mr-sneezy/ArduinoHondaOBD1_to_OBD2_BT/schematics/compact_schematic.pdf

SpiceOrder 2 | SpiceOrder 1 ARDUINO_NANO2

+5V

GND

GND

GND

1N4004

+12V

100R

GND

1N4734A

GND

4k7

GND

MODUL1

D1/TX

J1.1

D0/RX

J1.2

RESET

J1.3

COM

J1.4 D2

J1.5

D3

J1.6

D4

J1.7

D5

J1.8

D6

J1.9

D7

J1.10

D8

J1.11

D9

J1.12

D10

J1.13
D11/MOSI | J1.14
D12/MISO | J1.15

VIN

# J2.1 COM

J2.2

RESET

J2.3 | +5V J2.4

A7

J2.5

A6

J2.6

A5

J2.7

A4

J2.8

A3

J2.9

A2

J2.10

A1

J2.11

A0

J2.12

AREF

J2.13

3V3

# J2.14 D13/SCK

J2.15

BT_MODULE
1
2
3
4
5
6
7

HONDA_DLC
1
2
D1 | 3

R2

# + - BZ1 D2

R1

Document Number: Honda DLC to OBDII via Bluetooth Minimum parts version. | REV: 1.0
Date: 18-Aug-18 10:55 PM | Sheet: 1/1

## TITLE:

## Honda_DLC_OBDII_BT_Minimal

12V Power from DLC connector

5V micro-buzzer

Arduino Nano

5.6V
zener

Ignore pin numbering. Use the pin lables on your BT module. TXD to Nano D10. RXD to Nano D11. GND to Nano GND. 5V to Nano 5V. KEY not used. STATUS not used.

Arduino Nano: https://www.banggood.com/ATmega328P-Nano-V3-Controller-Board-Compatible-Arduino-p-940937.html

Bluetooth module: https://www.banggood.com/HC-05-Wireless-Bluetooth-Serial-Transceiver-Module-Slave-And-Master-p-908621.html

Honda DLC cable: https://www.ebay.com.au/itm/3Pin-to-16-Pin-OBD2-Female-Extension-Connector-Car-Cable-Diagnose-Tool-For-Honda/292440335602

Buzzer: https://www.banggood.com/5-Pcs-5V-Electromagnetic-Active-Buzzer-Continuous-Beep-Continuously-p-1035626.html

Notes: BT module gets power from Nano's 5V regulator.

If using Ebay Honda cable, cut off D-connector end and use the the DLC 3pin socket.
