mr-sneezy/ArduinoHondaOBD1_to_OBD2_BT/images/3.JPG

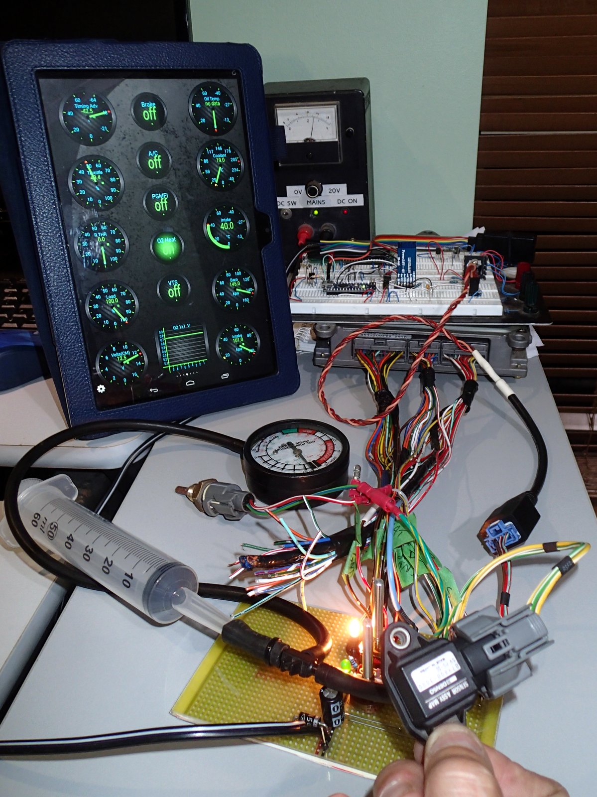
images/3.JPG
