mr-sneezy/ArduinoHondaOBD1_to_OBD2_BT/images/compact1.JPG

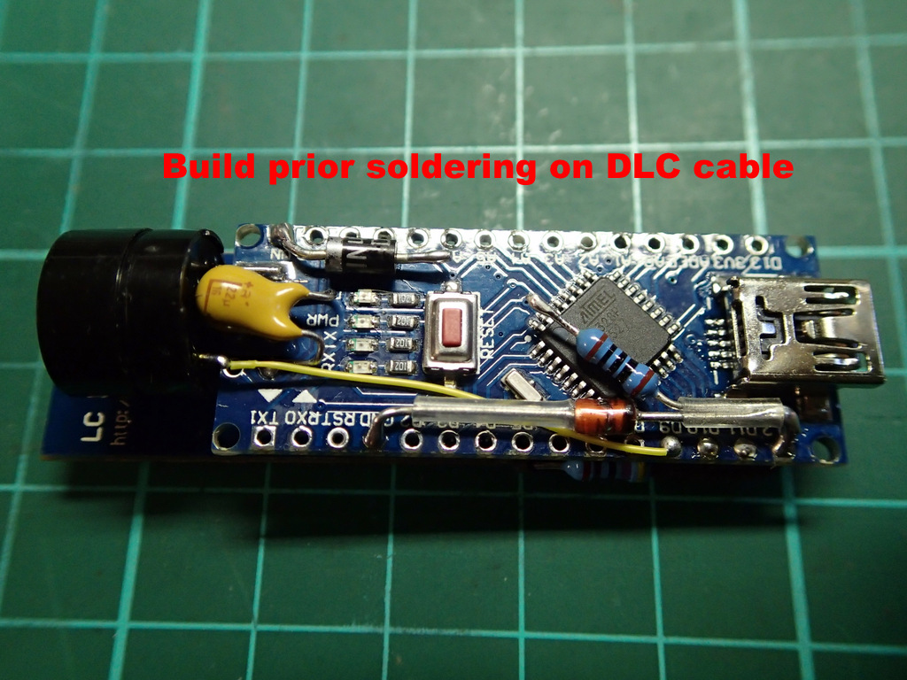
images/compact1.JPG
