mr-sneezy/ArduinoHondaOBD1_to_OBD2_BT/images/compact2.JPG

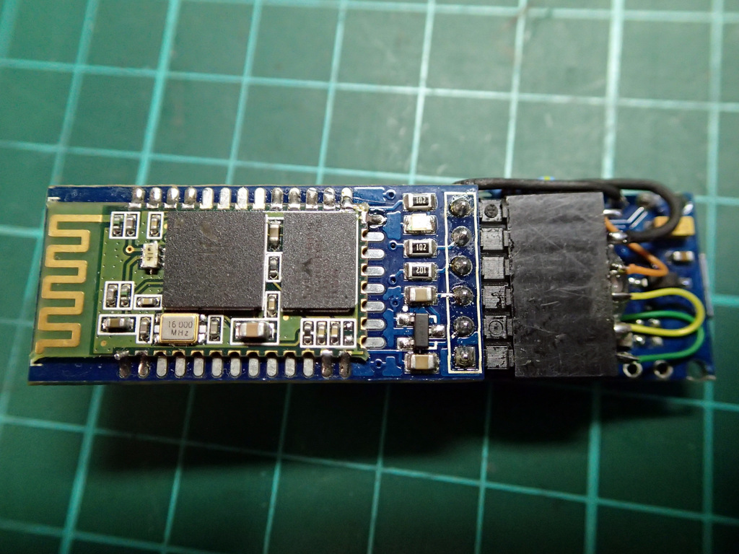
images/compact2.JPG
