mr-sneezy/ArduinoHondaOBD1_to_OBD2_BT/images/compact3.JPG

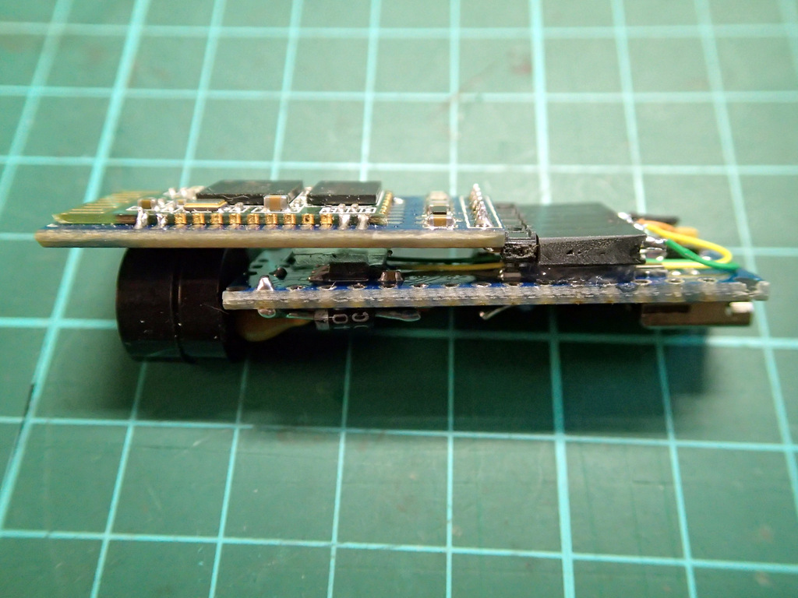
images/compact3.JPG
