mr-sneezy/ArduinoHondaOBD1_to_OBD2_BT/images/Compact version.JPG

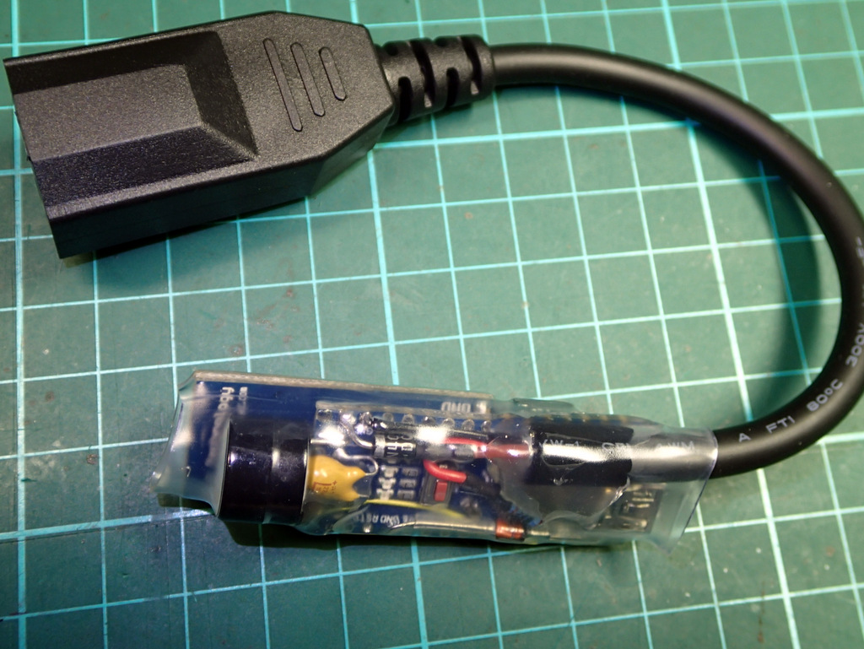
images/Compact version.JPG
