mr-sneezy/ArduinoHondaOBD1_to_OBD2_BT/images/differential_sensor.JPG

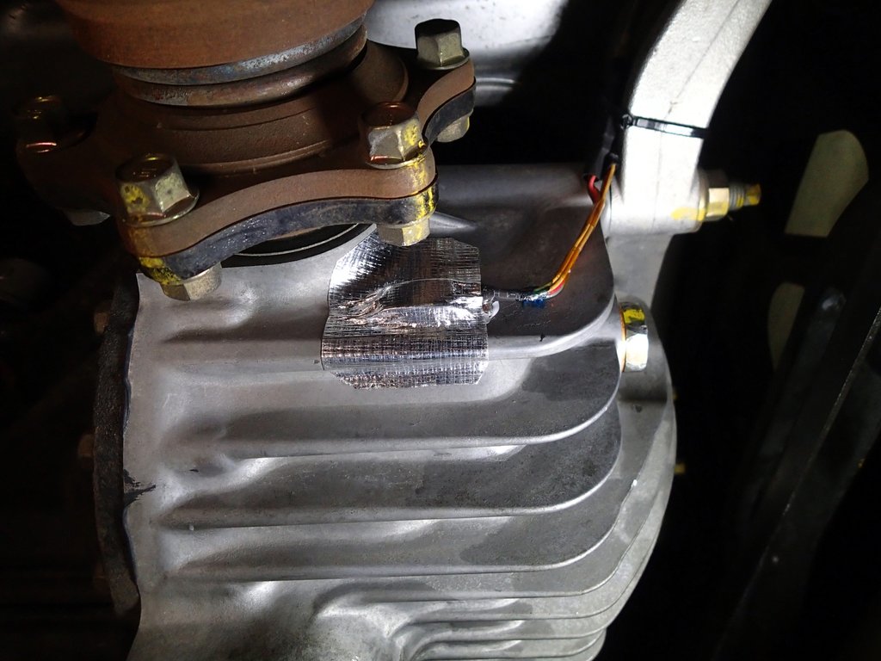
images/differential_sensor.JPG
