mr-sneezy/ArduinoHondaOBD1_to_OBD2_BT/images/expanded_sensor_version_boxed.JPG

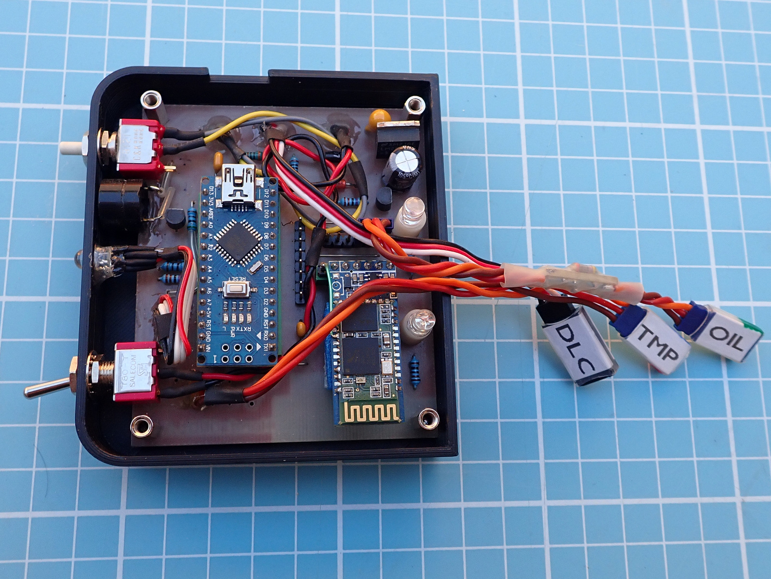
images/expanded_sensor_version_boxed.JPG
