mr-sneezy/ArduinoHondaOBD1_to_OBD2_BT/images/gearbox_sensor.JPG

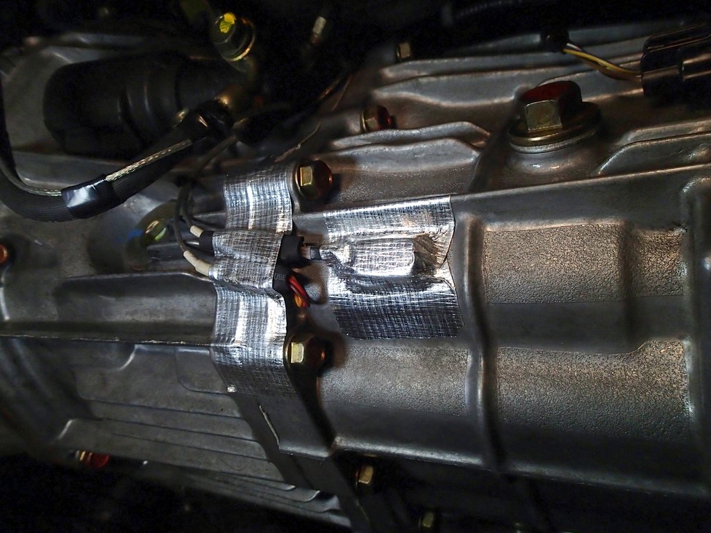
images/gearbox_sensor.JPG
