mr-sneezy/ArduinoHondaOBD1_to_OBD2_BT/images/Honda DLC to OBDII Ebay cable.JPG

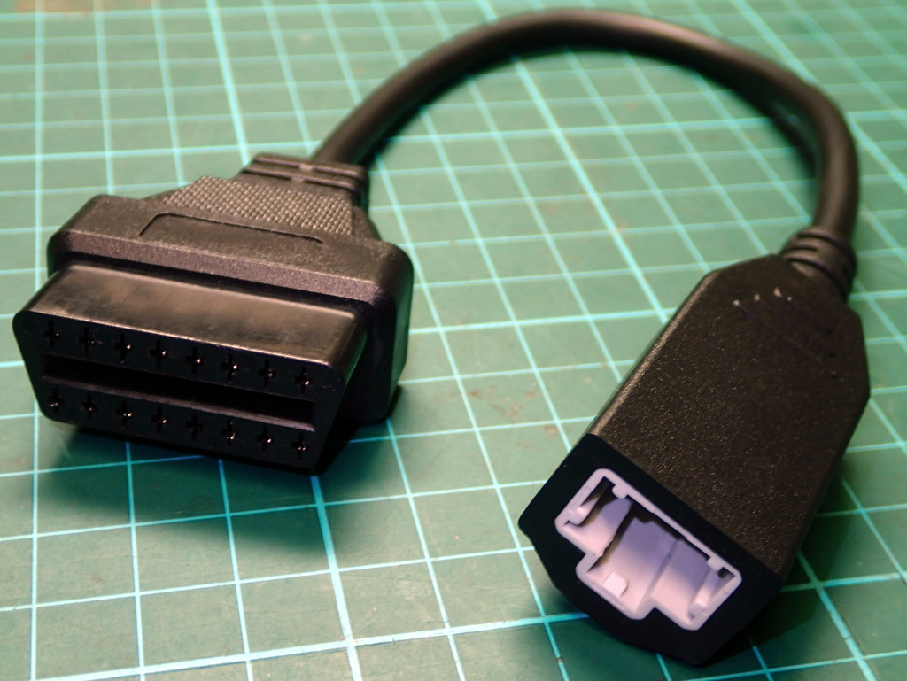
images/Honda DLC to OBDII Ebay cable.JPG
