mr-sneezy/ArduinoHondaOBD1_to_OBD2_BT/images/Honda_OBD_plug.JPG

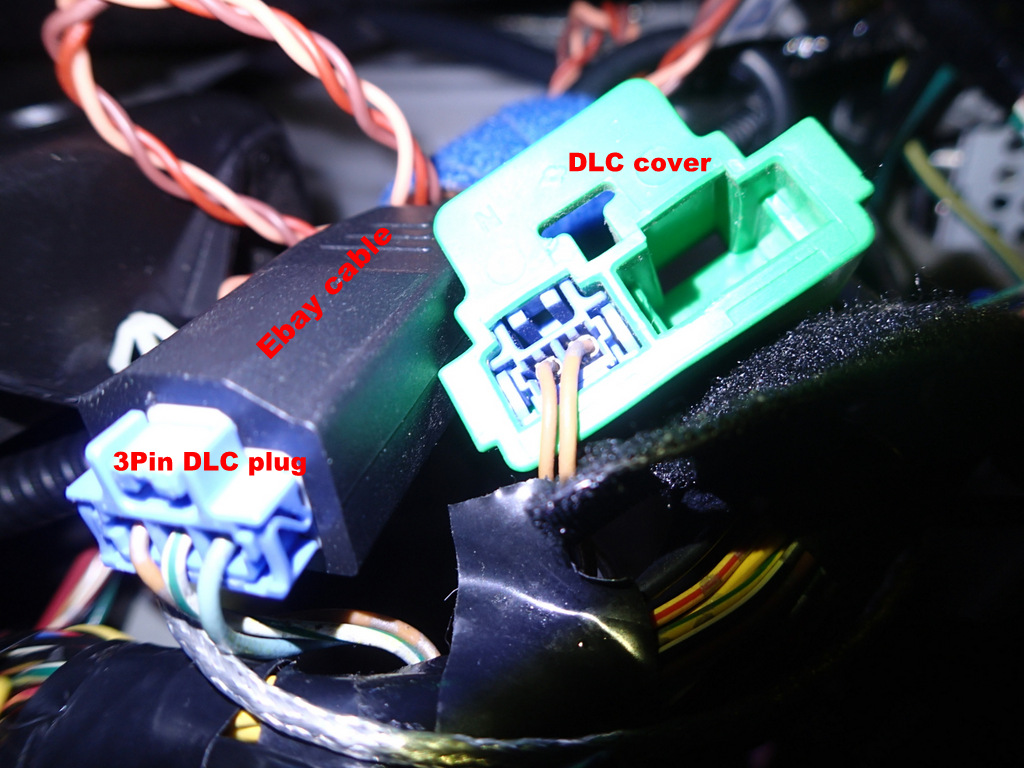
images/Honda_OBD_plug.JPG
