mr-sneezy/ArduinoHondaOBD1_to_OBD2_BT/images/oil_sensor.JPG

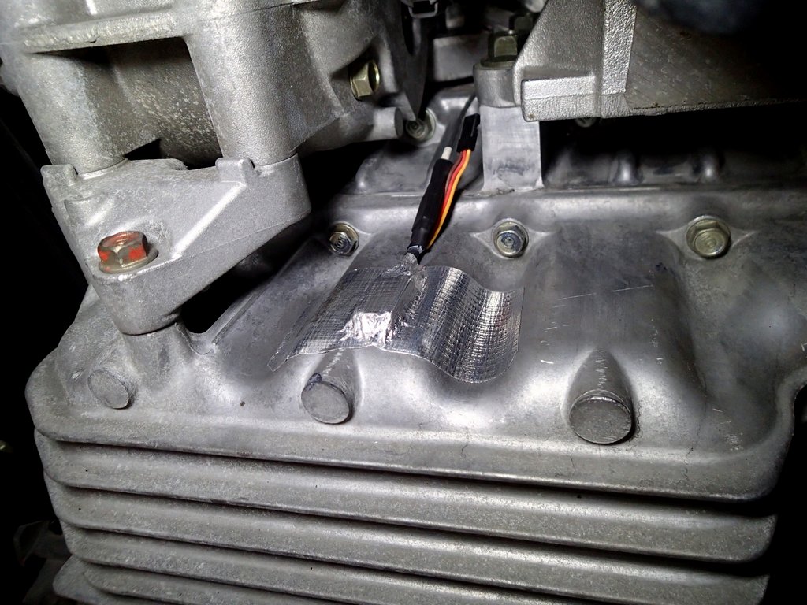
images/oil_sensor.JPG
