mr-sneezy/ArduinoHondaOBD1_to_OBD2_BT/images/Prepared cable.JPG

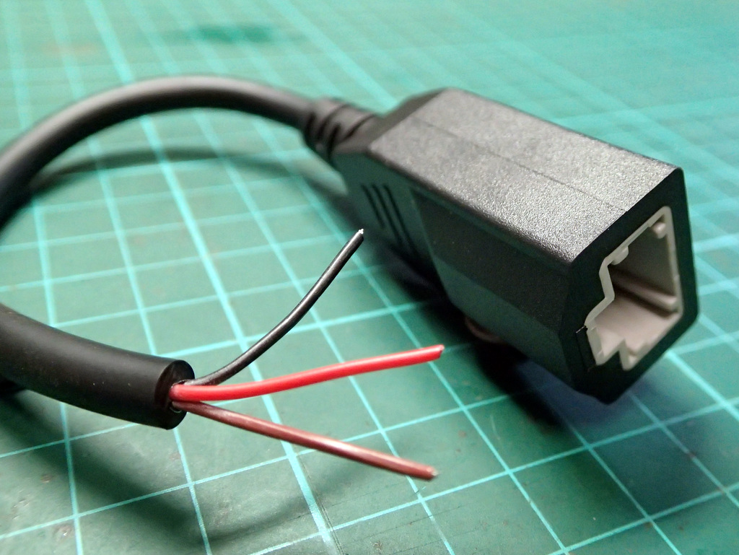
images/Prepared cable.JPG
