mr-sneezy/ArduinoHondaOBD1_to_OBD2_BT/images/prototype_PCB.JPG

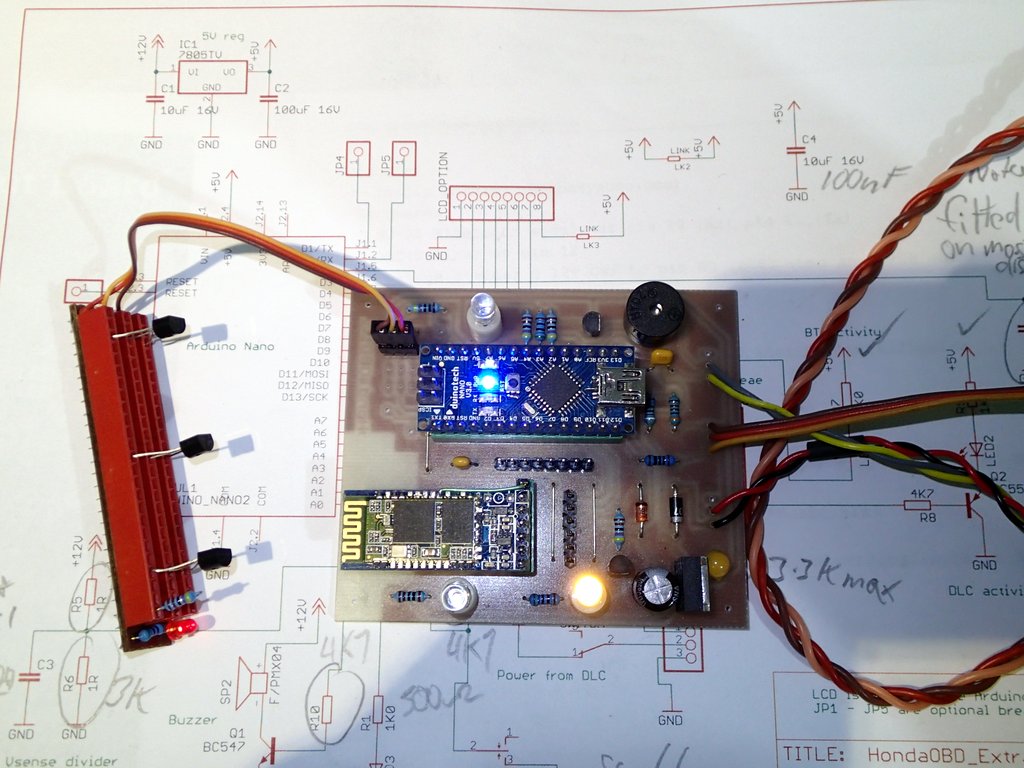
images/prototype_PCB.JPG
