mr-sneezy/ArduinoHondaOBD1_to_OBD2_BT/images/Cable soldered.JPG

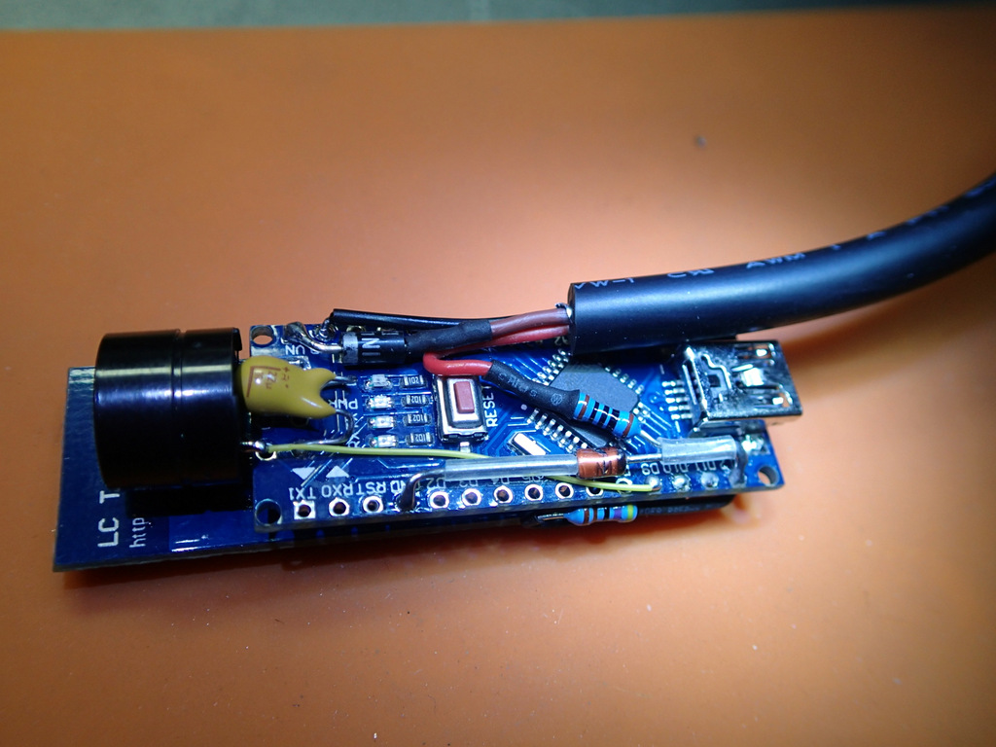
images/Cable soldered.JPG
