mr-sneezy/ArduinoHondaOBD1_to_OBD2_BT/schematics/HondaOBD_Extra_BT_only_rev3.pdf

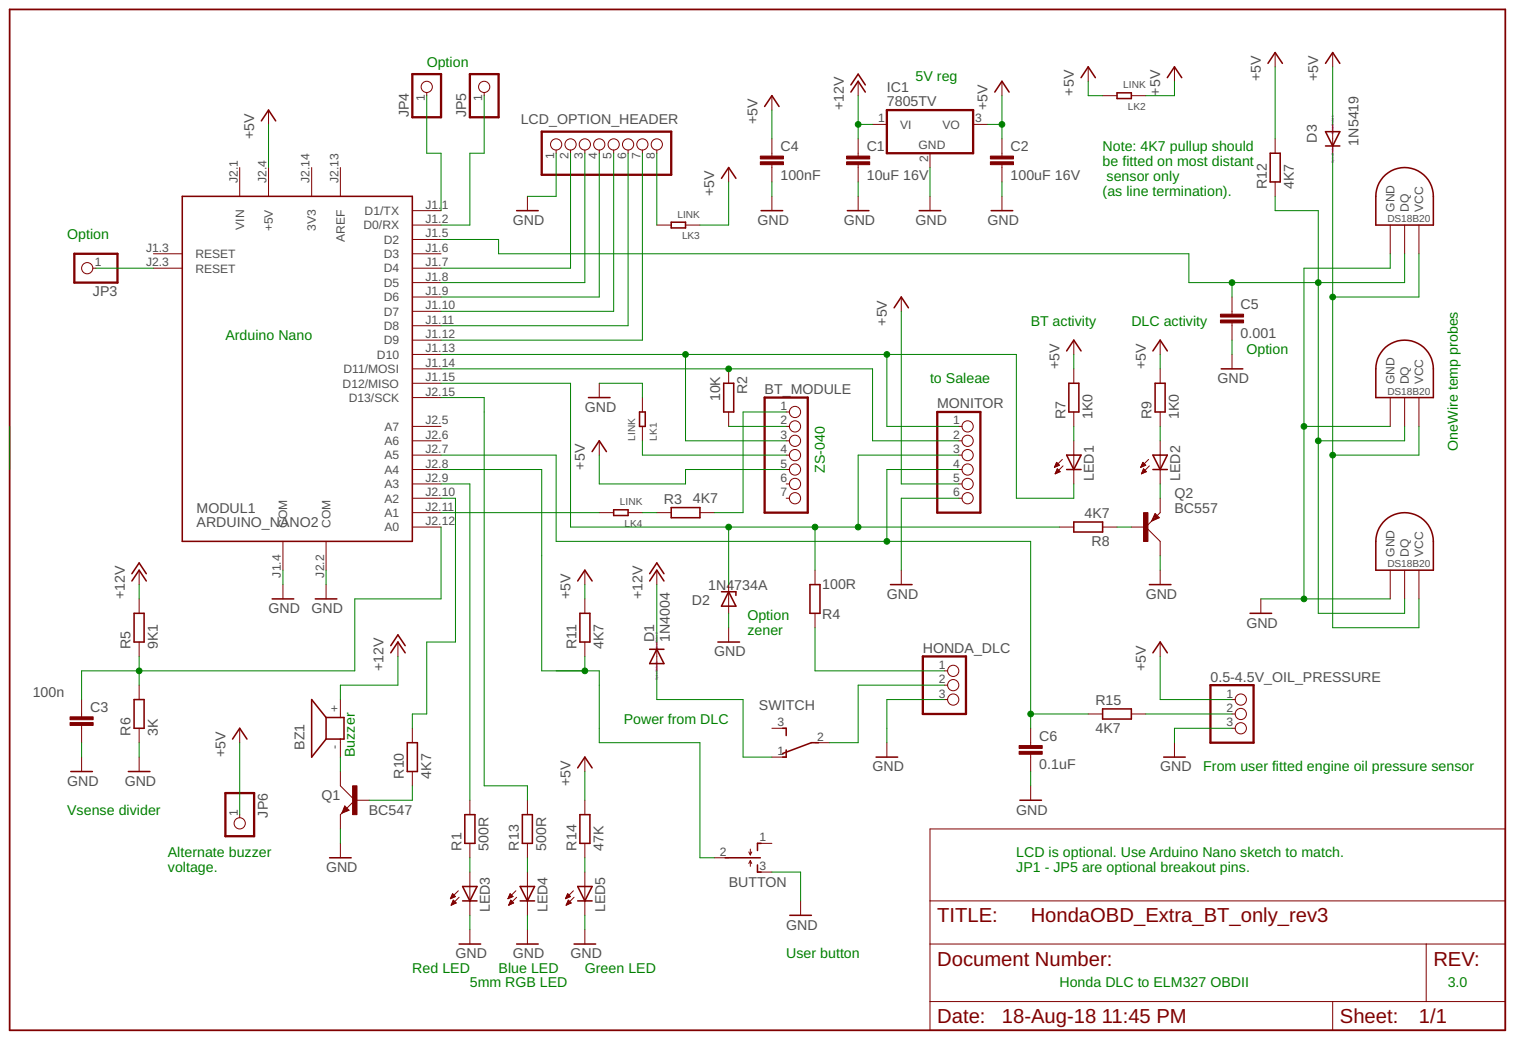
[picture p19: page 1]

Note: 4K7 pullup should
be fitted on most distant sensor only

J2.8
J2.9

From user fitted engine oil pressure sensor

LCD is optional. Use Arduino Nano sketch to match. JP1 - JP5 are optional breakout pins.

User button Red LED

Honda DLC to ELM327 OBDII
