mr-sneezy/ArduinoHondaOBD1_to_OBD2_BT/schematics/HondaOBD_Extra_BT_only_PCB.pdf

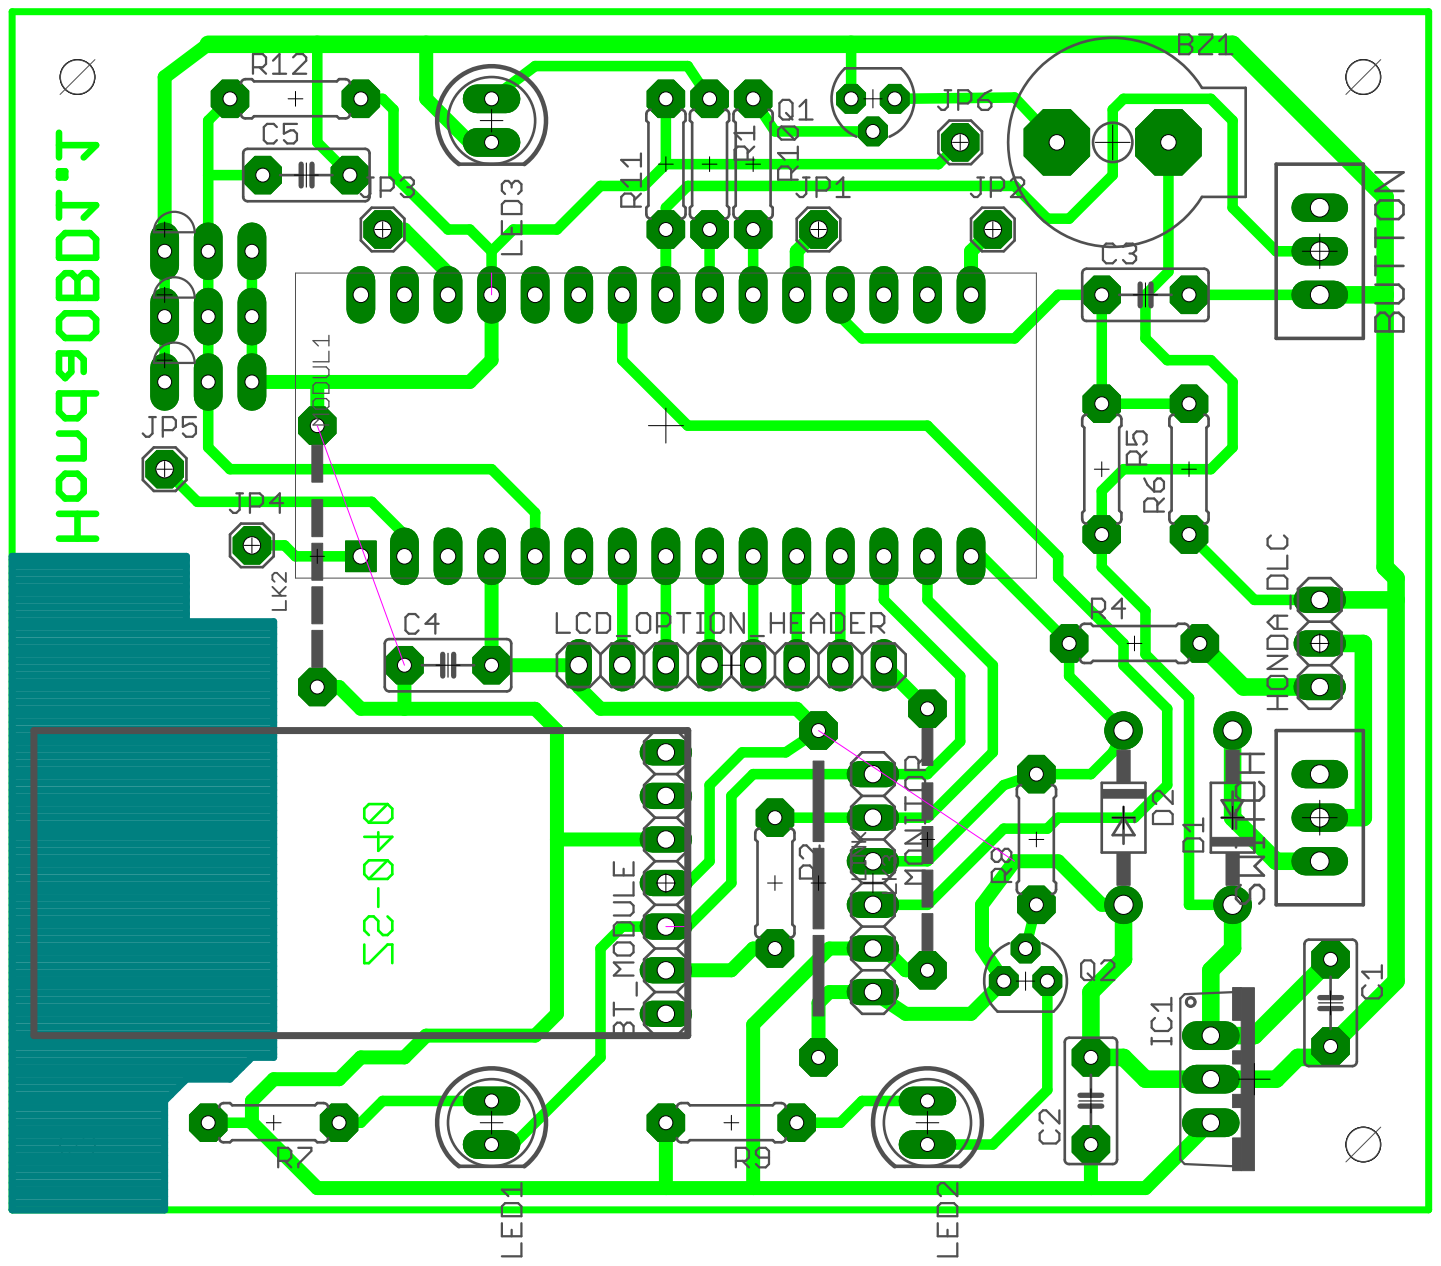
[picture p20: page 1]
