mr-sneezy/ArduinoHondaOBD1_to_OBD2_BT/(commit log)

2016-01-28 Working on the first DS18B20 sensor addition
    Changed OBDII PID validity flags, added 5C.
    Added partial code for new sensor.
2016-01-31 ## .gitignore * Created ## README.md * Updated with a cheeky comment ;) ## hobd_uni_S2000_alpha.ino * Changed brace style from C -> C++ (there are massive if/else statements - this makes it easier to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
2016-02-05 ## hobd_uni_S2000_alpha.ino * Removed delay from main loop * Moved bt listen() to setup() * Moved some sensors initialisation to setup() * Pre-allocate local byte Oil_Temp instead of passing it and t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
2016-02-06 Minor edits
    Changed author names, changed hardware items.
    Have verified that Dallas sensor values do display on Torque Android app
    correctly (Engine Oil Temp only as yet) on car.
2016-02-06 Added custom PIDs
    Added custom PID 2002 & 2003 for Dallas sensor 2 and 3. I can see raw
    valid data in Torque app but can't get the custom display to work yet.
2016-02-06 Solved major issue with custom PID's for Torque app
    Could not get custom PID's to display in Torque. Found out by deduction
    (as it's not documented) that Torque needs a custom PID command to be a
    minimum of three bytes long or response data is truncated away
    forever...
2016-02-08 * cleanup : initialised the input arrays instead to all zeros {0} which means that the memset commands are not required * dlcCommand : im not sure how data[] was actually being returned, so updated t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
2016-02-09 ## hobd_uni_S2000_alpha.ino * BUGFIX : Updated to fix bluetooth not working. Note: I suspect the SoftwareSerialWithHalfDuplex doesnt like multiple instances operating in listen() mode as i cannot int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
2016-02-10 ## hobd_uni_S2000_alpha.ino * I tried pushing the bluetooth module to hardware serial, but i somehow damaged the atmega chip in the process? This is the reason for the #define debugSerial as i switch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
2016-02-11 Fixed (maybe) some sensor conversions.
    Fiddling with conversions until I get them right.
2016-02-13 Some test hacking.
    Changed a type in the proclcd routine and hacked the LCD top line to
    show raw sensor outputs for debugging.
    Still got odd 55 value displayed on IAT and ECT when ECU off.
2016-06-21 Add files via upload
    Code tinkering has started again since I now have a way to test code much easier.
    1995 Honda Accord ECU on the desk talking to Torque...
2016-07-15 Adding DS18B20 fail warning and reset
    Testing button, buzzer.
2016-08-16 Latest revision schematic and board PDF's
2017-01-20 Further images - DS18B20 temp sensor installations.
2018-08-18 Uploaded first revision schematic for Compact version.
2018-08-18 Updated expanded version schematic
2018-08-19 Images of Compact version before cable fitted
2018-08-23 Custom PIDs in my Compact Version code
    [Custom PIDs for Expanded version hardware and FW.csv]
2018-08-23 Custom PIDs accessible in the EXpanded Version
    [Custom PIDs for Expanded version hardware and FW.csv]
2018-08-23 Custom PIDs accessible in the Compact Version code
    [custom PIDs for Compact version.csv]
2019-03-28 Update for Compact version
    Some new PIDs added for Injector time, IACV, second O2 sensor and more.
2021-03-06 Add files via upload
    Working prototype used in the S2000
2021-03-06 Add files via upload
    Expanded version prototype being used in an S2000
